ChikaraHanakawa/SweetsVendingMachine/hardware/README.md

# 筐体（ハードウェア）

研究室菓子自販機の 3D プリント筐体です．1 レーン・スパイラル式で，菓子袋を 5 個収納できます．

| ファイル | 内容 |
|---|---|
| [`BOM.md`](BOM.md) | 部品表（印刷部品・電子部品・ケーブル・ねじ） |
| [`stl/`](stl/) | 印刷用 STL（67 ファイル，ファイル名 = ボディ名） |
| [`acrylic_window.dxf`](acrylic_window.dxf) | 前面窓のアクリル板（120 × 145 × 2 mm）の外形と穴位置 |

- 外形: 幅 236 × 奥行き 207 × 高さ 246 mm（操作パネル・脚を含む）
- 内寸: 幅 124 × 奥行き 199 × 高さ 235 mm
- 設計: Autodesk Fusion（`Snack_Vending_Machine`）

## 構成

```
            ┌──────────── 天板 ────────────┐
  操作パネル │  モータ │  スパイラル（5 巻き） │ 窓（アクリル）
  ・PaSoRi   │  取付板 │                      │
  ・LED      ├─────────── 商品棚 ───────────┤ ← Z = 90
  ・スピーカー│ 電装室（Pi / Arduino / ULN2003）│
             │                  ＼ シュート    │ 取り出し口
            └──────────── 底板 ────────────┘
             背面                            前面
```

- スパイラルが 1 回転すると，袋が 1 個ずつ前へ送られ，棚の前端からシュートへ落ちます．
- 操作パネル（PaSoRi・LED・スピーカー）は**正面から見て右側**に付きます．

### 部品名の L / R について

部品名の L / R は設計座標（X の小さい側が L）で付けています．
**正面から見ると `Side_L` が右側（操作パネル側），`Side_R` が左側**になります．

### ブラケットの番号と取り付け位置

| 番号 | 継ぎ目 |
|---|---|
| `BR_01`〜`06` | 底板 × 側板下段（L: `01`〜`03`，R: `04`〜`06`） |
| `BR_07`, `08` | 底板 × 背面下段 |
| `BR_09`, `10` | 底板 × 前面下段（シュートの角の切り欠きに入る細幅） |
| `BR_11`〜`14` | 棚の下 × 側板下段（L: `11`, `12`，R: `13`, `14`） |
| `BR_15`〜`18` | 棚の上 × 側板上段（L: `15`, `16`，R: `17`, `18`） |
| `BR_19`, `20` | 棚の下 × 背面下段 |
| `BR_21`, `22` | 棚の上 × 背面上段 |
| `BR_23`〜`26` | モータ取付板 × 側板上段（L: `23`, `24`，R: `25`, `26`） |
| `BR_27`, `28` | モータ取付板 × 棚 |
| `BR_29`, `30` | シュート後ろ壁 × 底板 |
| `BR_31`〜`38` | 縦の角（L: 背面下 `31`・背面上 `32`・前面下 `33`・前面上 `34`，R: `35`〜`38` 同順） |
| `BR_39`〜`42` | 天板 × 側板上段 |
| `BR_43`〜`46` | 天板 × 前面上段（`43`, `45`）・背面上段（`44`, `46`） |

## 印刷

部品ごとの向きとサポートは [`BOM.md`](BOM.md) を参照してください．
サポートが必要なのはスパイラルだけです（ツリーサポート）．

## 組み立て前の準備

1. **ナットを入れる:** ブラケット・電装ベース・つなぎ板の六角穴に M3 ナットを押し込みます．
   操作パネル箱のフランジの六角穴（8 か所）にも内側から入れ，落ちないようにテープか少量の接着剤で留めます．
2. **アクリル板を加工する:** [`acrylic_window.dxf`](acrylic_window.dxf) のとおり，120 × 145 mm に切り，
   Ø3.4 の穴を 11 個あけます（窓の固定用 4 個 + ボルトの通し穴 7 個）．
   図の原点は，**箱の内側から見た左下の角**です．
3. **ボルト長さの目安:** 板 1 枚とブラケットを留める箇所は M3 × 8，
   棚（厚さ 5 mm）・アクリル板を挟む箇所・つなぎ板は M3 × 10 です．

## 組み立て手順

操作パネル箱の固定ボルトは**本体の内側から締めます**．シュートと棚を付けると手が届かなくなる箇所があるため，
次の順番で組み立ててください．

### 1. 底と電装ベース

1. 底板（前・後）を並べ，`BR_01`〜`08` を底板に留めます（ボルトの頭は底板の下面）．
   `BR_03` は側板側の穴を開けたままにします（手順 3 で操作パネルと共用）．
2. 電装ベースを底板に載せ，8 本で留めます（頭は底板の下面，ナットは電装ベース側）．
   このボルトが底板の前後もつなぎます．
3. Raspberry Pi 5 をスタンドオフに M2.5 × 6 で留めます．USB ポートを右（X の大きい側）に向けます．
4. ULN2003 と USB ハブを結束バンドで留めます．

### 2. 側板下段・背面下段

1. Arduino UNO R4 Minima を側板 L 下段のボスに M3 × 6 で留めます．
   **ヘッダのすぐ横のボス（上側の 1 か所）は，ねじの頭がヘッダに当たるため使いません．**
2. 側板 L 下段・R 下段を `BR_01`〜`06` に外側から留めます（`BR_03` の側板側を除く）．
3. 背面下段を `BR_07`, `08` と角の `BR_31`, `35` で留めます．
4. `BR_33`（前面下段の左の角）を，**側板 L 下段にだけ**先に留めておきます．
   このボルトの頭は，後で操作パネルの裏に隠れます．

### 3. 操作パネル

先に箱の中身を組み立ててから，側板 L 下段に取り付けます．

1. LED（緑・赤）を前面の穴に差し，ホットボンドで固定します．
2. スピーカーをスピーカー台に載せ，結束バンド（200 mm）を台の通し穴から両側の壁の外を回し，
   スピーカーの背面で締めます．スピーカーが前面の壁に押し付けられます．
3. スピーカー台を箱の底の下から M3 × 6 × 2 本で留めます．
4. PaSoRi を**ケーブルを挿さずに**開口側から入れます．**コネクタを上，読み取り面を前**に向け，
   受け台と爪の間を奥（止まる位置）まで滑らせます．
5. L 字 mini-USB ケーブルを上から差し込みます．プラグの頭は爪の切り欠きに収まります．
6. PaSoRi 押さえを開口側から M3 × 8 × 2 本で留めます．
7. ケーブルを次の順に通します．
   1. プラグのすぐ後ろで，天井下のリブの U 字の通し穴に結束バンドを通し，ケーブルを留めます．
   2. ケーブルを箱の後ろの壁へ回し，壁に沿って下ろします．
   3. 後ろの壁の 2 本のスリット（下から約 50 mm）にも結束バンドを通して留め，その間にたるみを残します．
   4. Z = 40 より下を通して，配線穴から本体側へ出します．
8. LED とスピーカーの配線も配線穴から本体側へ出します．
9. 箱を側板 L 下段に当て，**本体の内側から**次の 4 本を締めます．
   - 配線穴の真下と真上の 2 本（後ろから 126.5 mm，下から 14 mm・80 mm）
   - 底近くの 1 本（後ろから 144 mm，下から 6.5 mm）
   - `BR_03` を通る 1 本（M3 × 10．頭は `BR_03` の六角穴に入る）

### 4. シュートと棚

1. `BR_29`, `30` をシュートの後ろ壁に留め（頭は斜面の下側），シュートを置いて底板に下から留めます．
2. 棚に，棚側のボルトを先に入れたブラケットを付けておきます（作業台の上で行う）．
   - 棚の下: `BR_11`〜`14`，`BR_19`, `20`（頭は棚の上面）
   - 棚の上: `BR_15`, `17`, `18`，`BR_21`, `22`，`BR_27`, `28`（頭は棚の下面）
   - **`BR_16`（左前・上側）はまだ付けません．**
3. 棚を左右の側板下段の間に入れ（上面を側板下段の上端にそろえる），`BR_11`〜`14` を側板に，`BR_19`, `20` を背面下段に外側から留めます．

### 5. 側板上段

1. `BR_16` を，**側板 L 上段に先に**外側から留めておきます．
   このボルトの頭は操作パネルの裏に隠れるため，取り付け後は回せません．
2. 側板 L 上段・R 上段を上から差し込みます．
   L 上段は，操作パネルのフランジと本体の間に滑り込ませます．
3. `BR_15`〜`18` の残りの穴を留めます．`BR_16` の棚側は，前の取り出し口から棚の下に手を入れて留めます．
4. 操作パネルの上側の 4 本を本体の内側から締めます．
   - 配線穴と同じ列（後ろから 126.5 mm）の上の 2 本（下から 130 mm・175 mm）
   - 上の角の 1 本（下から 183.5 mm，後ろから 140 mm）
   - `BR_34` を通る 1 本（M3 × 10．`BR_34` を側板 L 上段に留めるボルトを兼ねる）

### 6. モータとスパイラル

1. 28BYJ-48 をモータ取付板の座ぐりに当て，M3 × 8 とナットで留めます．
2. カプラを軸に押し込みます．
3. モータ取付板を `BR_27`, `28`（棚）と `BR_23`〜`26`（側板上段）で留めます．
   取付板側のボルトは，背面（モータ室）側から入れます．
4. モータの配線を棚の長穴から電装室へ通します．
5. スパイラルを前から差し込み，ハブの六角穴をカプラにはめます．
   商品を手前に送るには，**背面から見て反時計回り**に回します．

### 7. 前面パネル

1. つなぎ板を前面下段の内側に当て，下の列 3 本を外側から M3 × 10 で留めます．
2. 前面下段を `BR_33`, `37`（角）と `BR_09`, `10`（シュートの角の切り欠き．底板側は下から）で留めます．
3. アクリル板を前面上段の内側に当て，四隅を M3 × 5 で留めます．
4. 前面上段を載せ，つなぎ板の上の列 3 本と，角の `BR_34`, `38` を外側から M3 × 10 で留めます（アクリル板を貫通）．

### 8. 背面上段（点検蓋）と天板

1. 背面上段を，角の `BR_32`, `36` と棚の `BR_21`, `22` で留めます．
2. 天板に `BR_39`〜`46` を天板側から留めておき，本体に載せて側板・前面・背面に外側から留めます．
   前面の `BR_43`, `45` はアクリル板を貫通するので M3 × 10 です．
3. 背面上段は，`BR_32`, `36`, `21`, `22`, `44`, `46` の 6 本を外すと取り外せます（モータ点検用）．

## 配線

| ケーブル | 経路 |
|---|---|
| Raspberry Pi 電源 | 背面下段のケーブル穴（背面から見て左下）から |
| Arduino ↔ Pi | Arduino の USB-C に L 字プラグ（背面下段の窓側）→ 電装室内で Pi へ |
| PaSoRi・スピーカー・LED | 操作パネルの配線穴 → 電装室内で Pi / Arduino へ |
| モータ | 棚の長穴 → ULN2003 |

背面下段の窓からは，筐体を開けずに Arduino へ書き込みできます．

## 未確認の点（実物合わせ）

- Arduino の取付穴位置（3D モデルに穴の形状がないため未照合）
- スピーカー（MS-U1）・USB ハブ・ULN2003 の寸法は仮の値です
- 28BYJ-48 の軸がカプラに約 7 mm 入る想定です（取付面から軸先端まで約 10 mm）
