ChikaraHanakawa/SweetsVendingMachine/qml/assets/soldout-zunda.gif

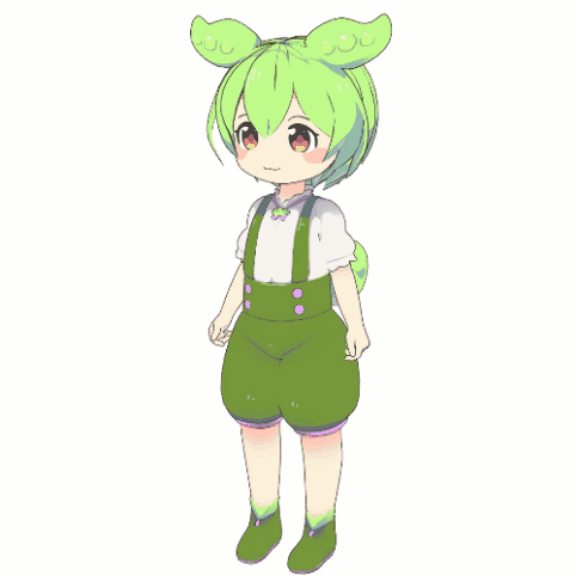
qml/assets/soldout-zunda.gif
