ChikaraHanakawa/SweetsVendingMachine/qml/assets/zunda-preparing.gif

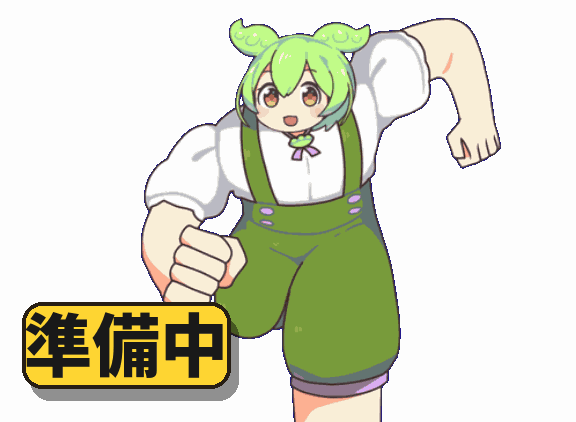
qml/assets/zunda-preparing.gif
