ChikaraHanakawa/SweetsVendingMachine/qml/assets/zunda-white.gif

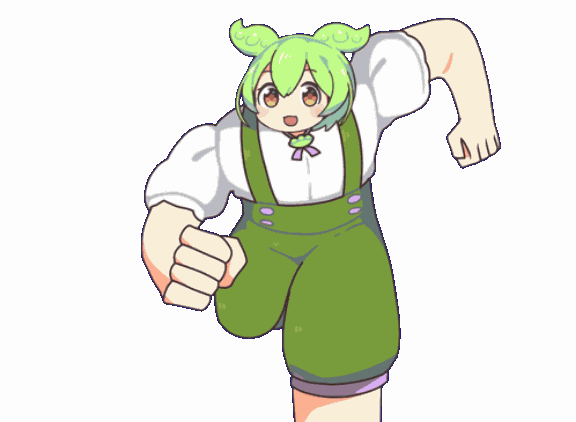
qml/assets/zunda-white.gif
