ChikaraHanakawa/SweetsVendingMachine/hardware/BOM.md

# 部品表（BOM）

筐体（1 レーン・スパイラル式）の組み立てに必要な部品の一覧です．
組み立て手順は [README.md](README.md) を参照してください．

## 1. 3D プリント部品

STL は [`stl/`](stl/) にあり，ファイル名はボディ名と同じです．
STL は組み立て状態の座標のまま出力しているので，スライサーで下表の向きに回転してから印刷してください．
すべて 210 × 190 × 240 mm（Adventurer 4 Lite の余裕込み）に収まります．

| ファイル | 部品 | 数 | 外形 X×Y×Z (mm) | 印刷の向き | サポート |
|---|---|---|---|---|---|
| `Spiral.stl` | スパイラル | 1 | 70 × 117 × 70 | ハブ円板を下 | **ツリーサポート要** |
| `Coupler_28BYJ.stl` | モータ軸カプラ | 1 | 11.5 × 11 × 10 | 六角面を下 | 不要 |
| `MotorPlate.stl` | モータ取付板 | 1 | 124 × 10 × 145 | 前面（リブのない面）を下 | 不要 |
| `ShelfTray.stl` | 商品棚 | 1 | 124 × 150 × 13 | 上面を下（リブを上） | 不要 |
| `Floor_Rear.stl` | 底板（後） | 1 | 132 × 107.5 × 7 | 上面を下（脚を上） | 不要 |
| `Floor_Front.stl` | 底板（前） | 1 | 132 × 99.5 × 7 | 上面を下（脚を上） | 不要 |
| `Chute.stl` | 取り出しシュート | 1 | 124 × 62 × 30 | 後ろ壁の外面を下 | 不要 |
| `Side_L_Lower.stl` | 側板 L 下段 | 1 | 14 × 207 × 90 | 外面を下（ボスを上） | 不要 |
| `Side_L_Upper.stl` | 側板 L 上段 | 1 | 4 × 207 × 145 | 内面を下 | 不要 |
| `Side_R_Lower.stl` | 側板 R 下段 | 1 | 4 × 207 × 90 | 外面を下 | 不要 |
| `Side_R_Upper.stl` | 側板 R 上段 | 1 | 4 × 207 × 145 | 内面を下 | 不要 |
| `Front_Lower.stl` | 前面パネル 下段 | 1 | 124 × 4 × 90 | 外面を下 | 不要 |
| `Front_Upper.stl` | 前面パネル 上段 | 1 | 124 × 4 × 145 | 外面を下 | 不要 |
| `Rear_Lower.stl` | 背面パネル 下段 | 1 | 124 × 4 × 90 | 外面を下 | 不要 |
| `Rear_Upper.stl` | 背面パネル 上段（点検蓋） | 1 | 124 × 4 × 145 | 外面を下 | 不要 |
| `Top.stl` | 天板 | 1 | 132 × 207 × 4 | 下面を下 | 不要 |
| `ElecBase.stl` | 電装ベース | 1 | 120 × 130 × 11 | 底面を下 | 不要 |
| `FrontSplice.stl` | 前面パネル上下のつなぎ板 | 1 | 92 × 5 × 24 | 段のない面（ナット穴の面）を下 | 不要 |
| `ControlPanel.stl` | 操作パネル箱 | 1 | 104 × 83 × 190 | 開口と反対の側面を下 | 不要 |
| `SpeakerCradle.stl` | スピーカー台 | 1 | 90 × 35 × 15 | 底面を下 | 不要 |
| `PasoriClamp.stl` | PaSoRi 押さえ | 1 | 63 × 13 × 118.5 | 背面の板を下 | 不要 |
| `BR_01`〜`BR_46.stl` | L 字ブラケット | 46 | 下表 | L 字の断面が見える向き | 不要 |

- 外面が見える部品（前面・背面・側板・天板・操作パネル）は，見える面をベッド側にすると仕上がりがきれいです．
- 側板と天板は 207 mm の辺をベッドの X 方向（210 mm）に合わせてください．

### L 字ブラケットの内訳

形の同じものは同じ STL を複数回印刷して構いません．

| 種類 | 外形 (mm) | 数 | ファイル |
|---|---|---|---|
| 標準 | 15 × 15 × 20 | 36 | `BR_01`〜`08`, `11`〜`14`, `16`, `18`, `23`〜`32`, `34`〜`36`, `38`〜`46` |
| 細幅（シュート角） | 21 × 15 × 7 | 2 | `BR_09`, `BR_10` |
| 奥行き 19 | 15 × 15 × 19 | 2 | `BR_15`, `BR_17` |
| 奥行き 18 | 15 × 15 × 18 | 4 | `BR_19`〜`BR_22` |
| 前面下段の角 | 21 × 15 × 12 | 2 | `BR_33`, `BR_37` |

### 推奨の印刷設定

- 材料: PLA
- 積層ピッチ 0.2 mm，壁 3 周以上
- インフィル: パネル類 20 %，ブラケット・カプラ・スパイラル 40 % 以上

## 2. 電子部品

| 部品 | 数 | 備考 |
|---|---|---|
| Raspberry Pi 5 | 1 | 電装ベースのスタンドオフに M2.5 で固定 |
| Raspberry Pi 5 用 電源（USB-C，5 V 5 A） | 1 | 背面下段のケーブル穴から通す |
| Arduino UNO R4 Minima | 1 | 側板 L 下段のボスに M3 で固定 |
| ステッピングモータ 28BYJ-48（5 V） | 1 | |
| ULN2003 ドライバ基板 | 1 | 電装ベースに結束バンドで固定 |
| Sony PaSoRi RC-S380 | 1 | 実測 57 × 97.5 × 10 mm |
| スピーカー MS-U1 | 1 | 実測 幅 85 × 高さ 42 × 奥行き 35 mm |
| USB ハブ | 1 | 32 × 60 mm 以内，高さ 22 mm 以内を想定 |
| LED 5 mm（緑・赤） | 各 1 | 電流制限抵抗は回路に合わせて選定 |

## 3. ケーブル

| 部品 | 数 | 備考 |
|---|---|---|
| mini-USB（L 字）– USB-A ケーブル | 1 | PaSoRi 用．**PaSoRi の底面側（台形の幅の広い辺の側）へケーブルが出る向き**のもの．ストレートは入りません |
| USB-C（L 字）– USB-A ケーブル | 1 | Arduino 用．背面下段の窓側へ差す |
| USB-A L 字プラグのケーブル（または L 字アダプタ） | 必要数 | Raspberry Pi の USB ポート用．ポート前の空間は約 20 mm |

## 4. 締結部品・その他

| 部品 | 数 | 用途 |
|---|---|---|
| M3 × 8 ボルト | 90 | ブラケット・電装ベース・操作パネル（86），PaSoRi 押さえ（2），モータ（2） |
| M3 × 10 ボルト | 26 | 棚・アクリル板を挟む箇所・つなぎ板・操作パネル共用部 |
| M3 × 6 ボルト | 5 | スピーカー台（2），Arduino（3） |
| M3 × 5 ボルト | 4 | アクリル板 |
| M3 ナット | 114 | ブラケット等（112），モータ（2） |
| M2.5 × 6 ボルト | 4 | Raspberry Pi |
| M3 ワッシャー | 2 | モータ取付耳（任意） |
| 結束バンド（幅 3.6 mm 以下，長さ 150 mm） | 約 10 | ULN2003・USB ハブ・配線押さえ・PaSoRi ケーブル |
| 結束バンド（幅 3.6 mm 以下，長さ 200 mm） | 1 | スピーカー |
| アクリル板 120 × 145 × 2 mm | 1 | 前面の窓．穴あけ図は [`acrylic_window.dxf`](acrylic_window.dxf) |

- M3 のボルト頭は**高さ 3 mm 以下**のものを使ってください（底板の脚と同じ高さのため）．
- アクリル板の M3 × 5 と，スピーカー台・PaSoRi 押さえ・Arduino のねじは，樹脂の下穴（Ø2.5）に直接ねじ込みます．
