ChikaraHanakawa/SweetsVendingMachine/hardware/acrylic_window.dxf

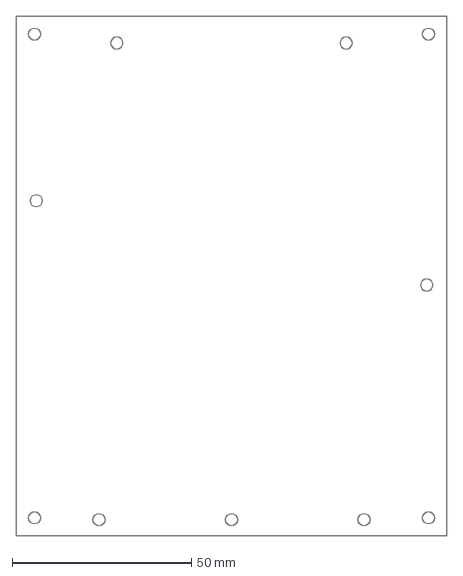
[picture p4: CAD file, 2026-11-08]
hardware/acrylic_window.dxf
120.0 x 145.0 mm
