ChikaraHanakawa/SweetsVendingMachine/hardware/stl/PasoriClamp.stl

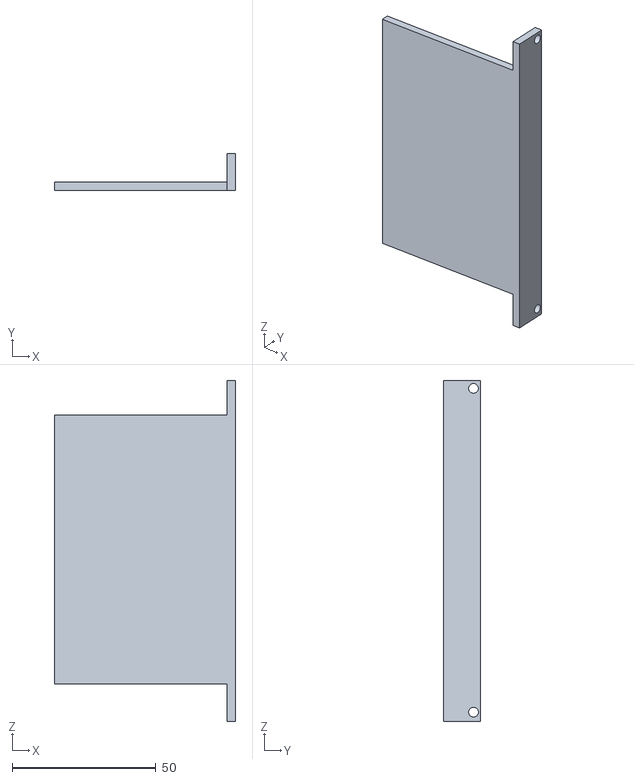
[picture p5: CAD file, 2026-11-11]
hardware/stl/PasoriClamp.stl
63.0 x 13.0 x 118.5
