ChikaraHanakawa/SweetsVendingMachine/hardware/stl/ControlPanel.stl

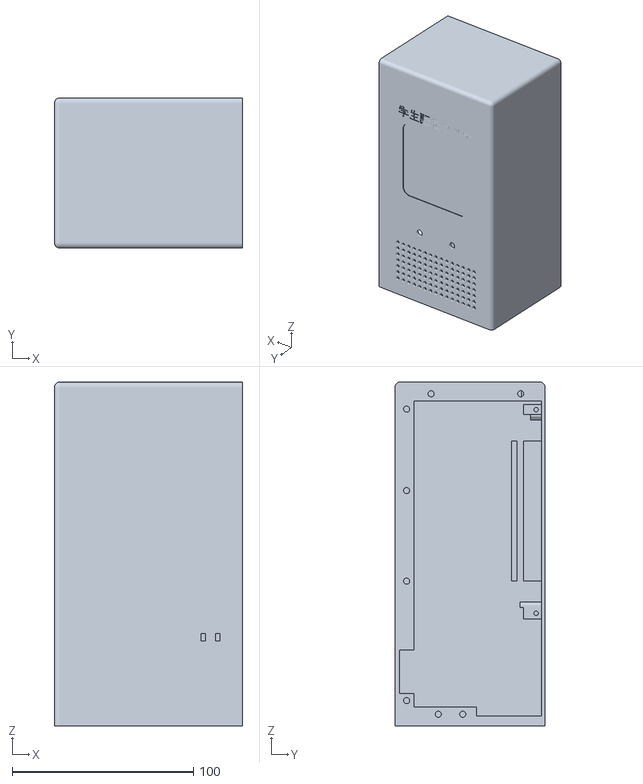
[picture p6: CAD file, 2026-11-11]
hardware/stl/ControlPanel.stl
104.0 x 83.0 x 190.0
