ChikaraHanakawa/SweetsVendingMachine/hardware/stl/SpeakerCradle.stl

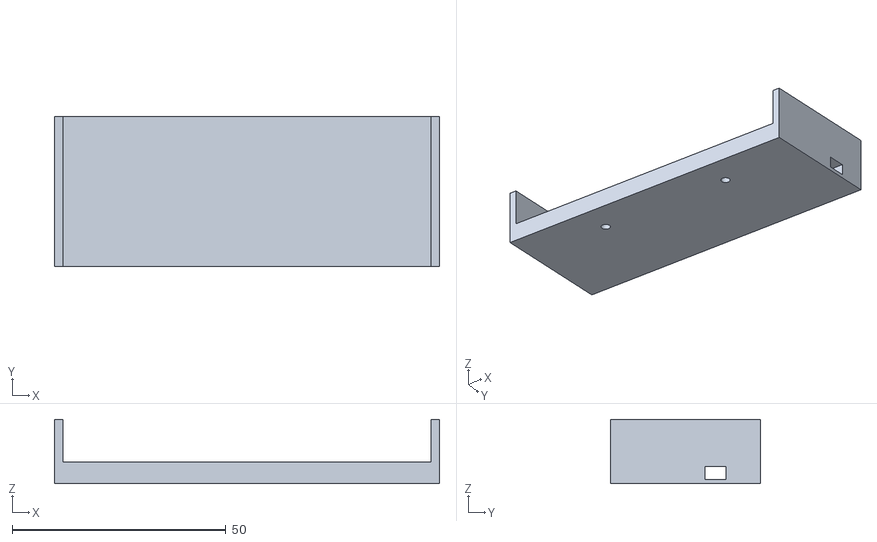
[picture p7: CAD file, 2026-11-11]
hardware/stl/SpeakerCradle.stl
90.0 x 35.0 x 15.0
