ChikaraHanakawa/SweetsVendingMachine/hardware/stl/BR_03.stl

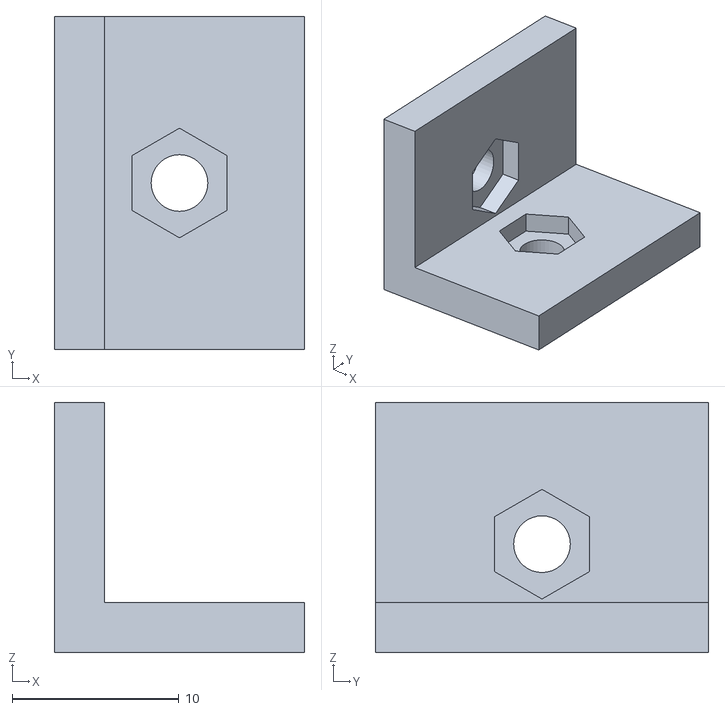
[picture p8: CAD file, 2026-11-08]
hardware/stl/BR_03.stl
15.0 x 20.0 x 15.0
