ChikaraHanakawa/SweetsVendingMachine/hardware/stl/BR_37.stl

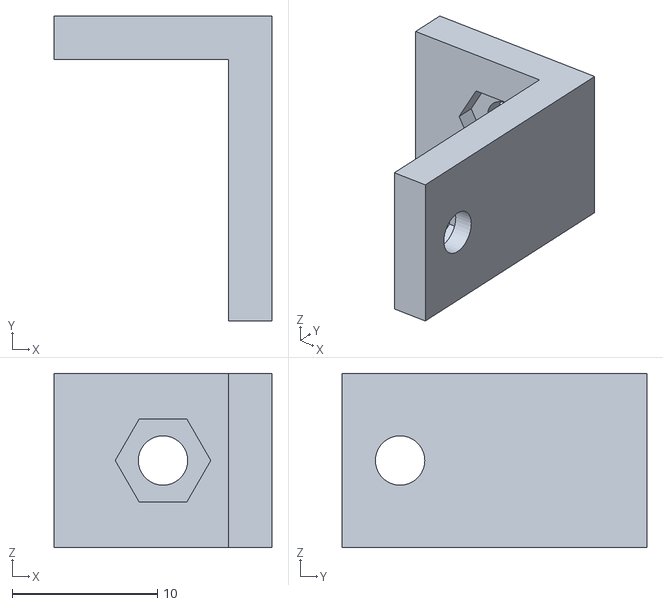
[picture p9: CAD file, 2026-11-08]
hardware/stl/BR_37.stl
15.0 x 21.0 x 12.0
