ChikaraHanakawa/SweetsVendingMachine/hardware/stl/Chute.stl

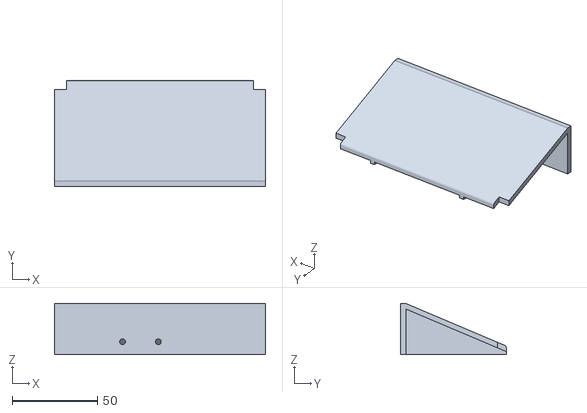
[picture p10: CAD file, 2026-11-08]
hardware/stl/Chute.stl
124.0 x 62.0 x 30.0
