ChikaraHanakawa/SweetsVendingMachine/hardware/stl/FrontSplice.stl

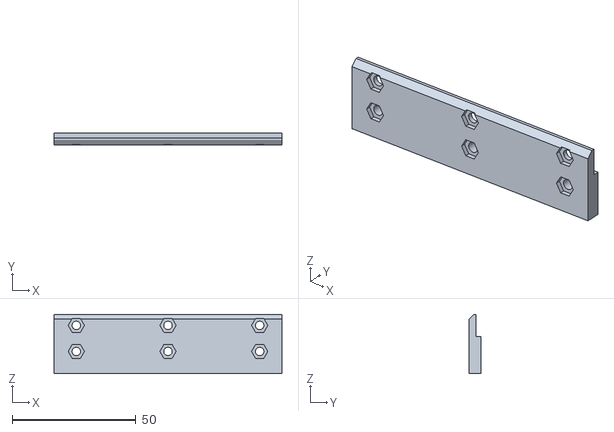
[picture p11: CAD file, 2026-11-08]
hardware/stl/FrontSplice.stl
92.0 x 5.00 x 24.0
