ChikaraHanakawa/SweetsVendingMachine/hardware/stl/Floor_Front.stl

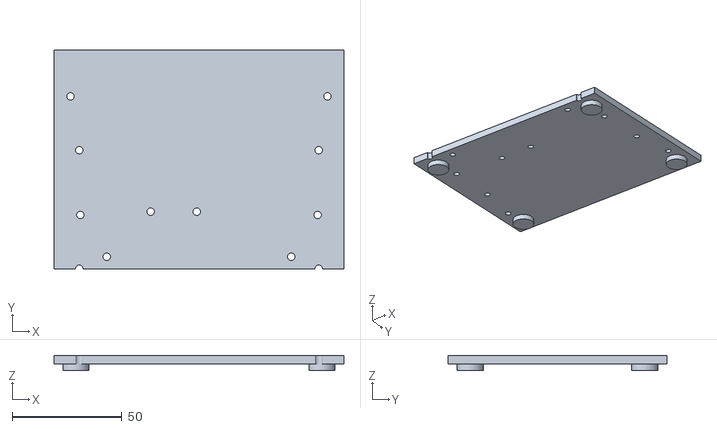
[picture p12: CAD file, 2026-11-08]
hardware/stl/Floor_Front.stl
132.0 x 99.5 x 7.00
