ChikaraHanakawa/SweetsVendingMachine/hardware/stl/BR_17.stl

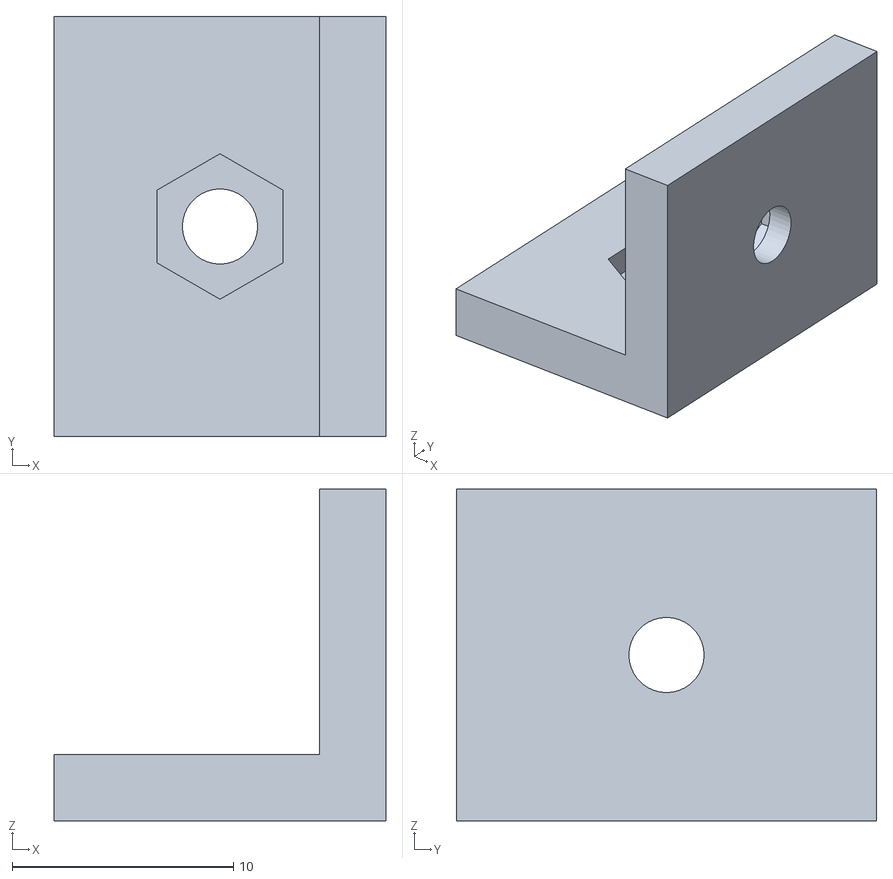
[picture p13: CAD file, 2026-11-08]
hardware/stl/BR_17.stl
15.0 x 19.0 x 15.0
