ChikaraHanakawa/SweetsVendingMachine/hardware/stl/BR_22.stl

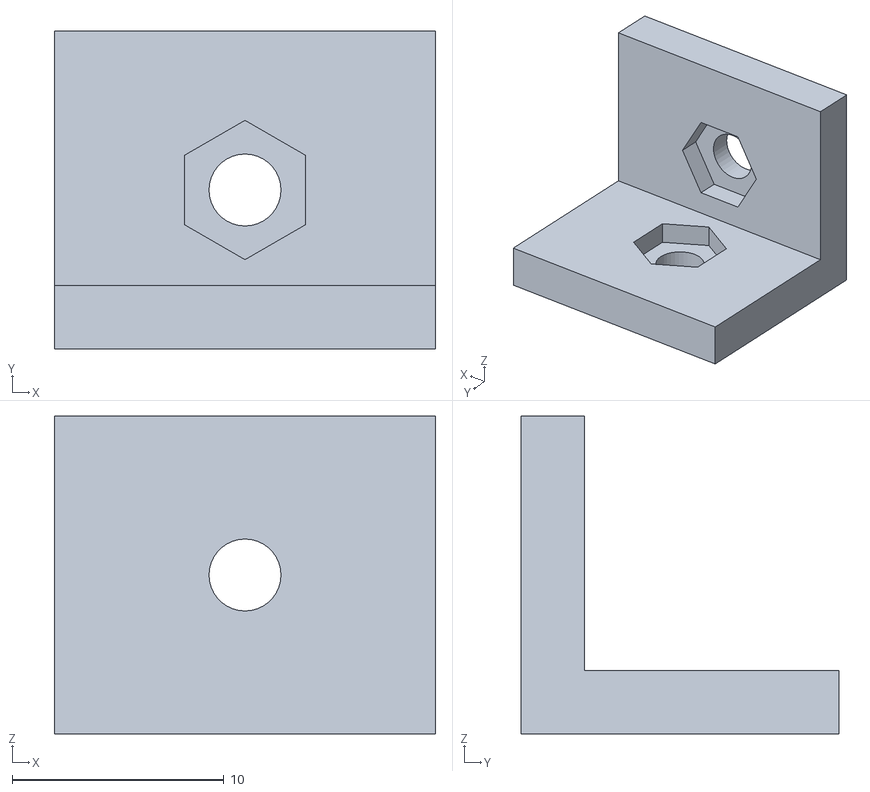
[picture p14: CAD file, 2026-11-08]
hardware/stl/BR_22.stl
18.0 x 15.0 x 15.0
