ChikaraHanakawa/SweetsVendingMachine/hardware/stl/ElecBase.stl

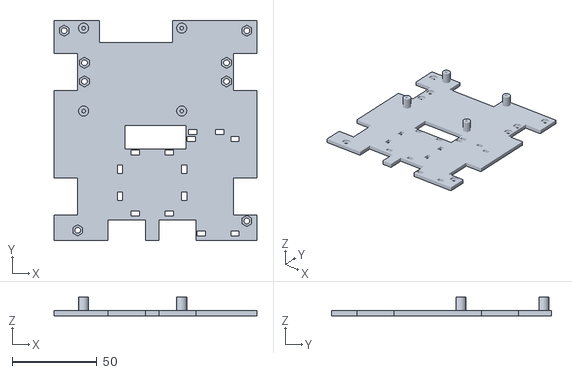
[picture p15: CAD file, 2026-11-08]
hardware/stl/ElecBase.stl
120.0 x 130.0 x 11.0
