ChikaraHanakawa/SweetsVendingMachine/hardware/stl/Side_L_Upper.stl

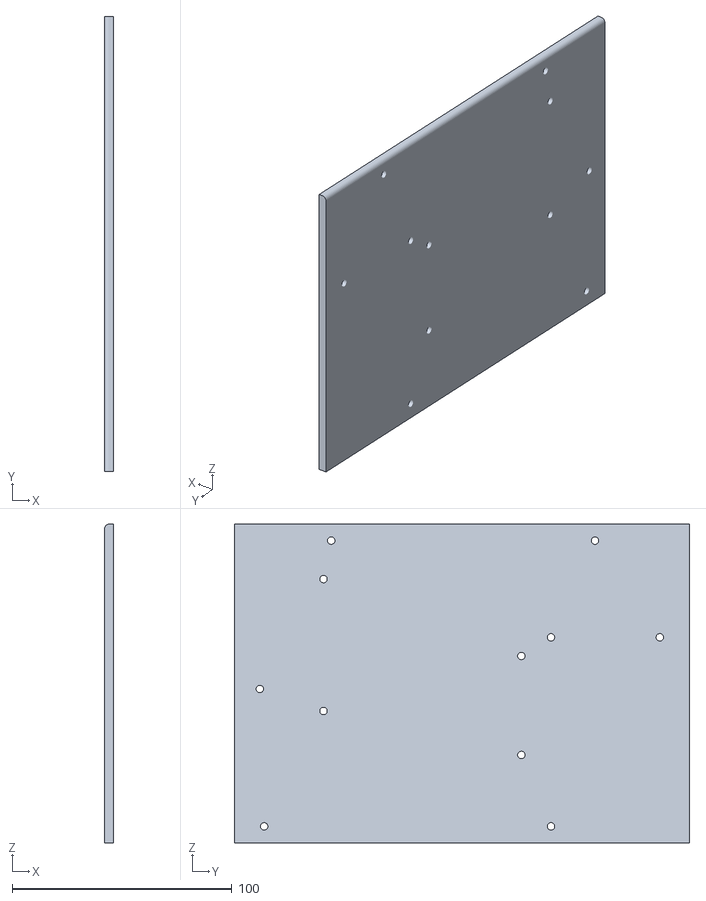
[picture p16: CAD file, 2026-11-08]
hardware/stl/Side_L_Upper.stl
4.00 x 207.0 x 145.0
