ChikaraHanakawa/SweetsVendingMachine/hardware/stl/Rear_Upper.stl

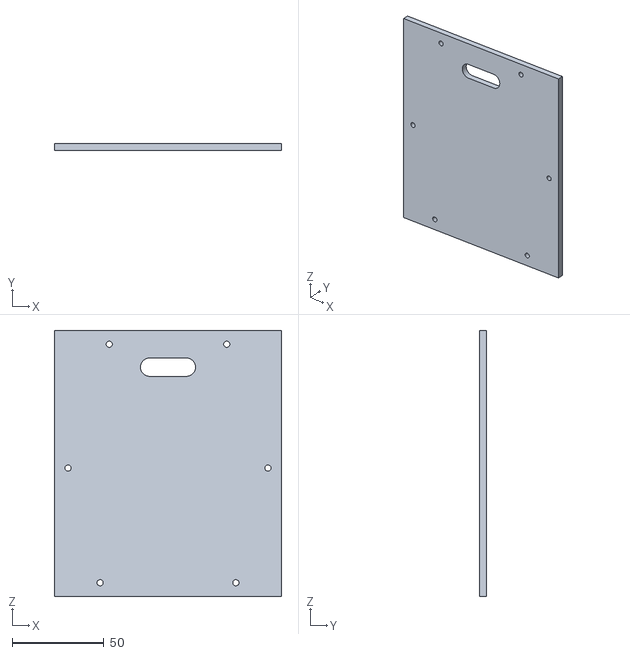
[picture p17: CAD file, 2026-11-08]
hardware/stl/Rear_Upper.stl
124.0 x 4.00 x 145.0
