ChikaraHanakawa/SweetsVendingMachine/hardware/stl/Top.stl

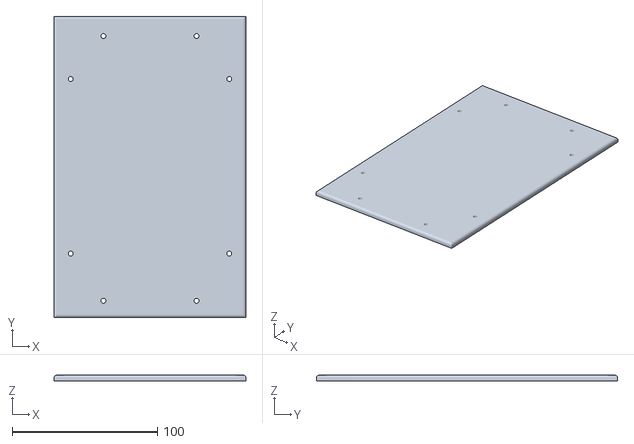
[picture p18: CAD file, 2026-11-08]
hardware/stl/Top.stl
132.0 x 207.0 x 4.00
