ChikaraHanakawa/SweetsVendingMachine/hardware/stl/Spiral.stl

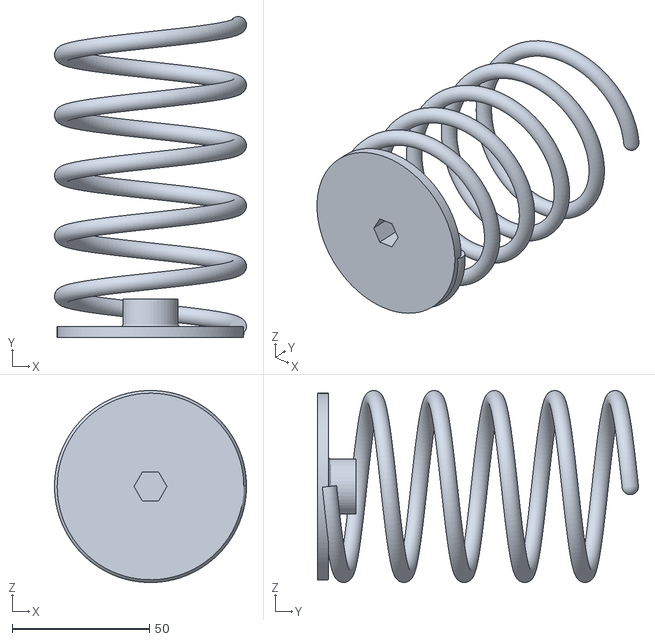
[picture p19: CAD file, 2026-11-08]
hardware/stl/Spiral.stl
70.0 x 117.0 x 70.0
