ChikaraHanakawa/SweetsVendingMachine/hardware/stl/Coupler_28BYJ.stl

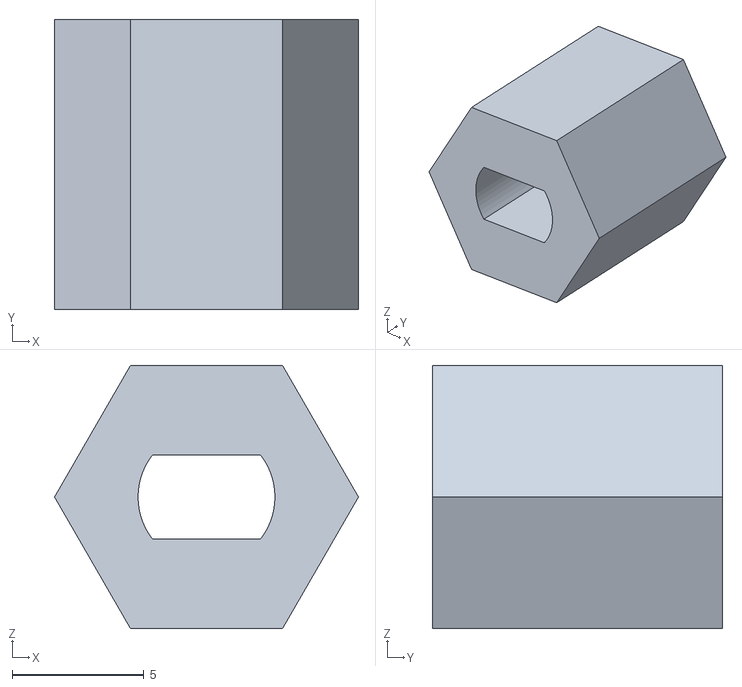
[picture p20: CAD file, 2026-11-08]
hardware/stl/Coupler_28BYJ.stl
11.5 x 11.0 x 10.0
