ChikaraHanakawa/SweetsVendingMachine/hardware/stl/ShelfTray.stl

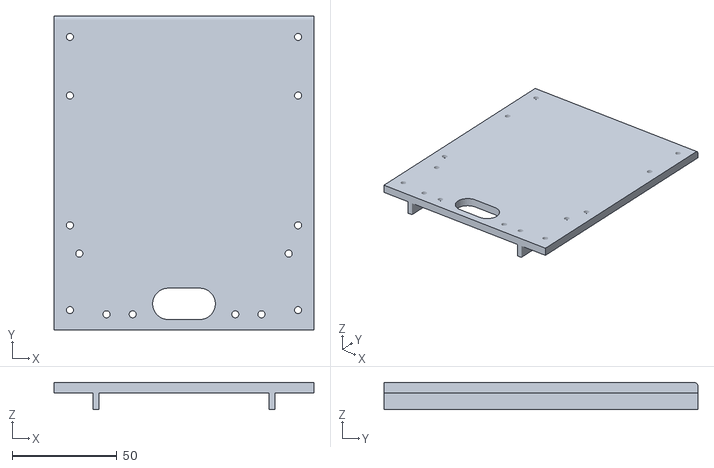
[picture p21: CAD file, 2026-11-08]
hardware/stl/ShelfTray.stl
124.0 x 150.0 x 13.0
