ChikaraHanakawa/SweetsVendingMachine/hardware/stl/Side_L_Lower.stl

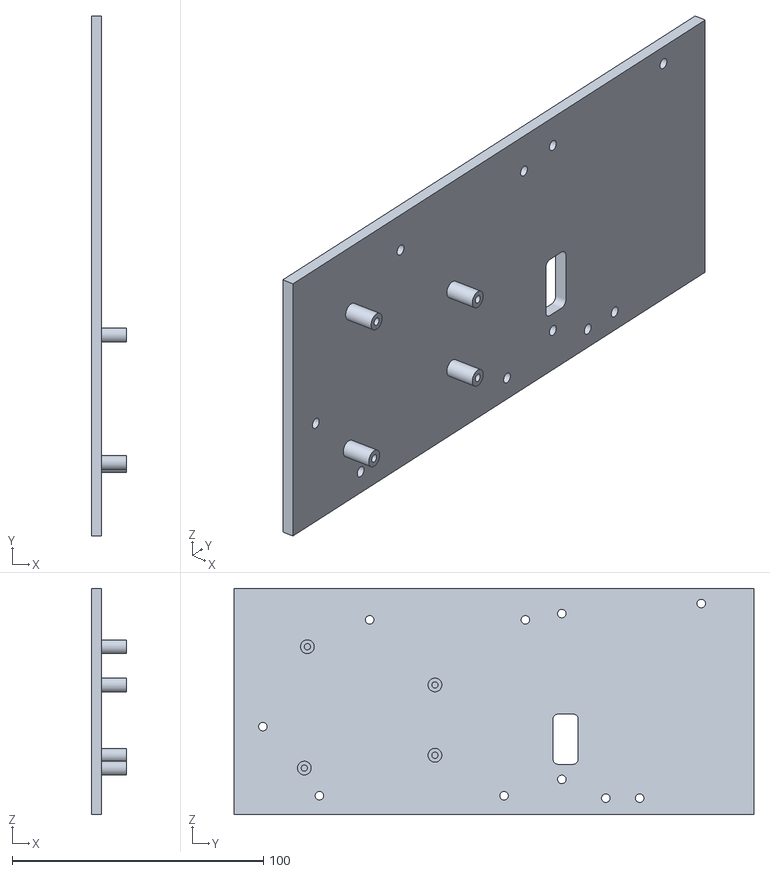
[picture p22: CAD file, 2026-11-08]
hardware/stl/Side_L_Lower.stl
14.0 x 207.0 x 90.0
