ChikaraHanakawa/SweetsVendingMachine/hardware/stl/Side_R_Lower.stl

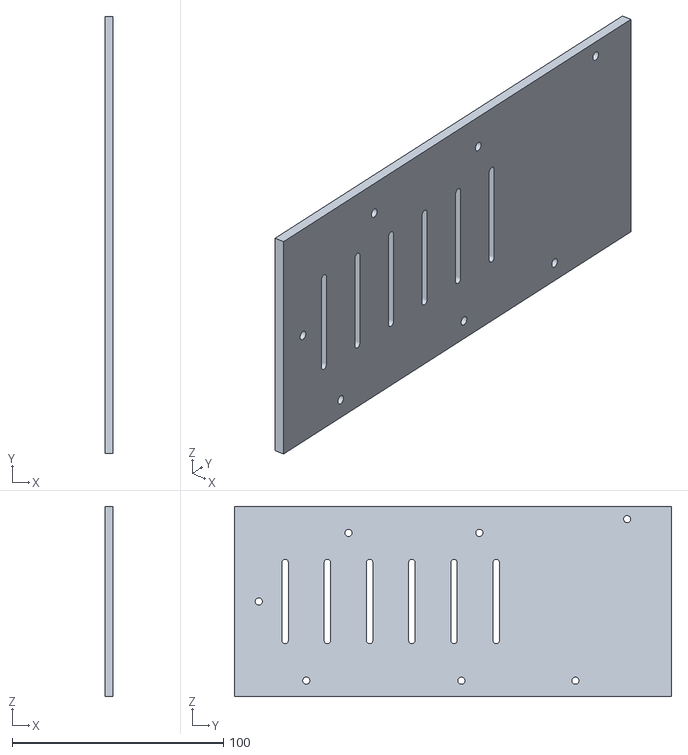
[picture p23: CAD file, 2026-11-08]
hardware/stl/Side_R_Lower.stl
4.00 x 207.0 x 90.0
