ChikaraHanakawa/SweetsVendingMachine/hardware/stl/Front_Lower.stl

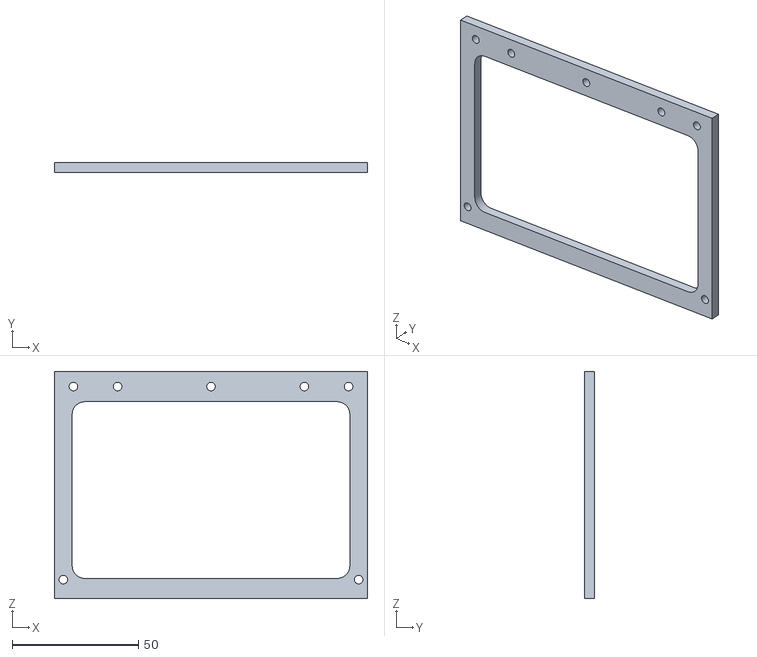
[picture p24: CAD file, 2026-11-08]
hardware/stl/Front_Lower.stl
124.0 x 4.00 x 90.0
