ChikaraHanakawa/SweetsVendingMachine/hardware/stl/Front_Upper.stl

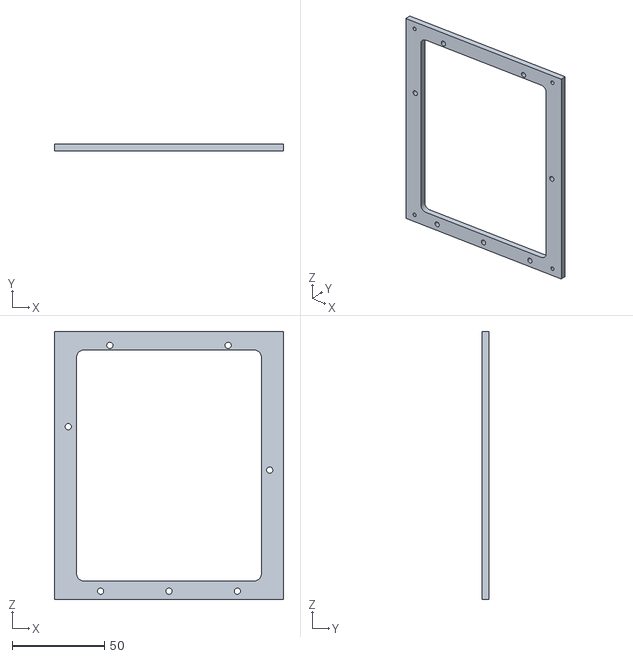
[picture p25: CAD file, 2026-11-08]
hardware/stl/Front_Upper.stl
124.0 x 4.00 x 145.0
