ChikaraHanakawa/SweetsVendingMachine/hardware/stl/Floor_Rear.stl

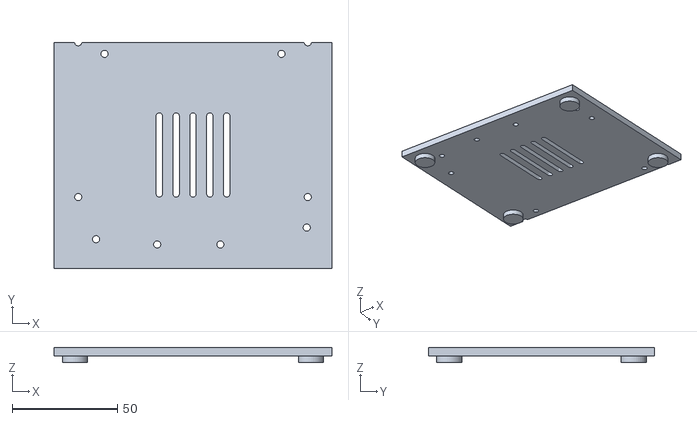
[picture p26: CAD file, 2026-11-08]
hardware/stl/Floor_Rear.stl
132.0 x 107.5 x 7.00
