ChikaraHanakawa/SweetsVendingMachine/hardware/stl/MotorPlate.stl

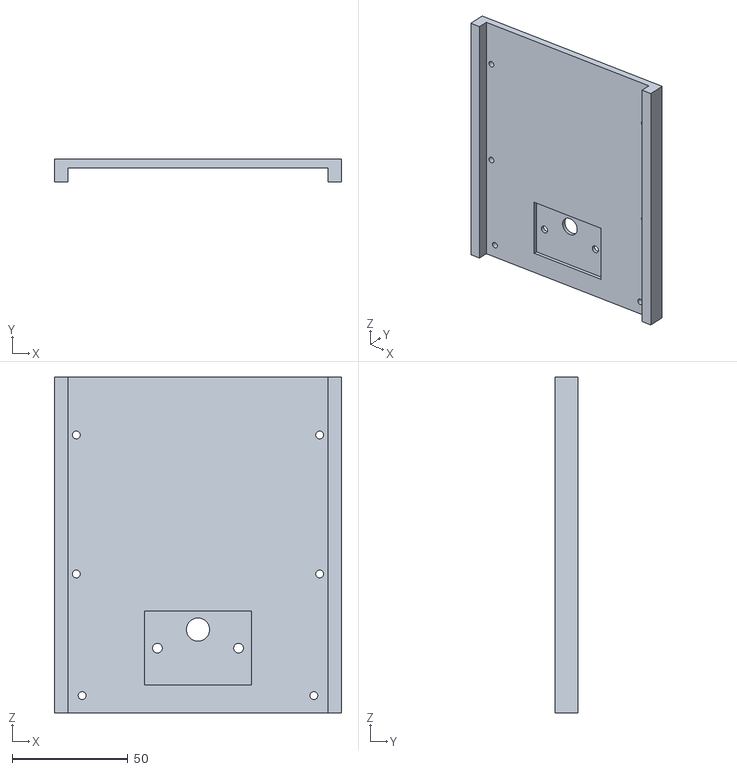
[picture p27: CAD file, 2026-11-08]
hardware/stl/MotorPlate.stl
124.0 x 10.0 x 145.0
