ChikaraHanakawa/SweetsVendingMachine/hardware/stl/Rear_Lower.stl

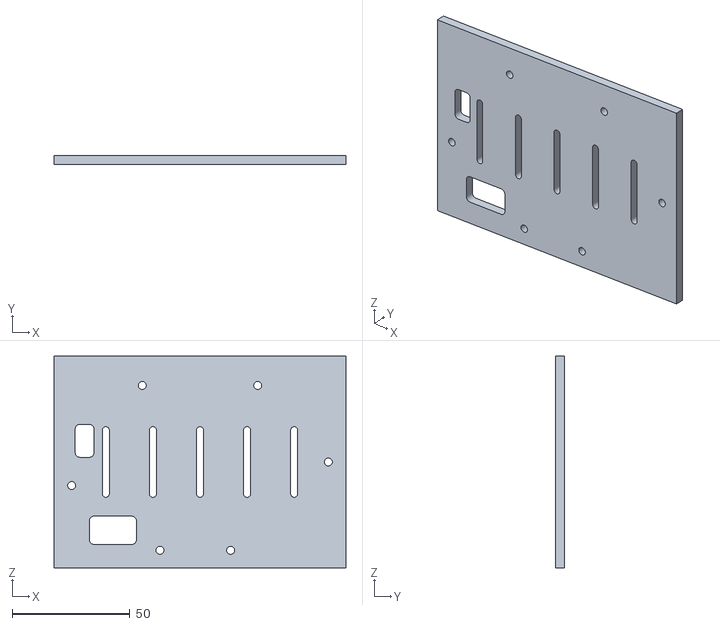
[picture p28: CAD file, 2026-11-08]
hardware/stl/Rear_Lower.stl
124.0 x 4.00 x 90.0
