ChikaraHanakawa/SweetsVendingMachine/hardware/stl/BR_10.stl

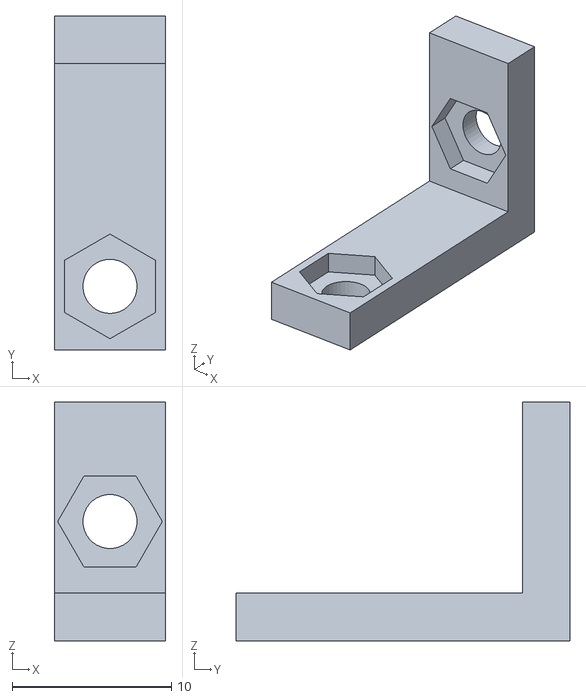
[picture p29: CAD file, 2026-11-08]
hardware/stl/BR_10.stl
7.00 x 21.0 x 15.0
