ChikaraHanakawa/SweetsVendingMachine/(list of files, cad)

Other CAD files:
hardware/stl/BR_35.stl
hardware/stl/BR_12.stl
hardware/stl/BR_29.stl
hardware/stl/BR_36.stl
hardware/stl/BR_25.stl
hardware/stl/BR_16.stl
hardware/stl/BR_34.stl
hardware/stl/BR_39.stl
hardware/stl/BR_18.stl
hardware/stl/BR_30.stl
hardware/stl/BR_26.stl
hardware/stl/BR_27.stl
hardware/stl/BR_01.stl
hardware/stl/BR_33.stl
hardware/stl/BR_23.stl
hardware/stl/BR_15.stl
hardware/stl/BR_31.stl
hardware/stl/BR_38.stl
hardware/stl/BR_02.stl
hardware/stl/BR_46.stl
hardware/stl/BR_28.stl
hardware/stl/BR_41.stl
hardware/stl/BR_40.stl
hardware/stl/BR_14.stl
hardware/stl/BR_07.stl
hardware/stl/BR_21.stl
hardware/stl/BR_04.stl
hardware/stl/BR_11.stl
hardware/stl/BR_43.stl
hardware/stl/BR_05.stl
hardware/stl/Side_R_Upper.stl
hardware/stl/BR_20.stl
hardware/stl/BR_13.stl
hardware/stl/BR_44.stl
hardware/stl/BR_32.stl
hardware/stl/BR_06.stl
hardware/stl/BR_45.stl
hardware/stl/BR_19.stl
hardware/stl/BR_42.stl
hardware/stl/BR_24.stl
hardware/stl/BR_08.stl
hardware/stl/BR_09.stl
