ChikaraHanakawa/SweetsVendingMachine/src/nfc_bridge.cpp

#include "common.h"
#include "nfc_bridge.h"
#include "aplay.h"
#include "read_csv.h"

#include <pybind11/embed.h>

extern std::atomic<bool> running;

void feedback_play_wav(int state){
    std::string path = "database/wav/";
    switch (state){
        case 0 :
            path += "reg_student.wav";
            break;
        case 1 :
            path += "not_reg_student.wav";
            break;
        case 2 :
            path += "error_student.wav";
            break;
    }
    zundamon_wav(path);  
}                           

void nfc_py_read(){     
    std::cout << "[Read] CSVファイルを読み込みます" << std::endl;
    InputCsvObject member = reading_csv();
    std::map<std::string, std::string> table = member.get_lab_member();

    pybind11::scoped_interpreter guard{};
    std::cout << "[pybind11] 認証システムを開始します" << std::endl;
    try {
        pybind11::module_ sys = pybind11::module::import("sys");
        sys.attr("path").cast<pybind11::list>().append("./src/");
        sys.attr("path").cast<pybind11::list>().append(".");

        pybind11::module_ nfc_mod = pybind11::module_::import("nfc_reader");

        std::cout << "カードをかざして下さい" << std::endl;

        while (running){
            std::string student_id = nfc_mod.attr("NFCReader")().attr("read_student_id")().cast<std::string>();

            if (!running) break;
            if (student_id.empty() || student_id.rfind("Error", 0) == 0) continue;

            if (!student_id.empty() && student_id.rfind("Error", 0) != 0){
                std::cout << "[Success] 学籍番号: " << student_id << std::endl;
                if (table.find(student_id) != table.end()) {
                    std::cout << "[Registered] 登録済みメンバーです" << std::endl;
                    feedback_play_wav(0);
                } else {
                    std::cout << "[Not Registered] 未登録のメンバーです" << std::endl;
                    feedback_play_wav(1);
                }
            } else {
                std::cerr << "[Error] 読み取り失敗; " << student_id << std::endl;
                feedback_play_wav(2);
            }
            std::this_thread::sleep_for(std::chrono::seconds(2));
        }
    }
    catch (pybind11::error_already_set &e){
        if (e.matches(PyExc_KeyboardInterrupt)){
            std::cout << "[Info] KeyboardInterruptを受信しました" << std::endl;
        } else if (running){
            std::cerr << "[Except] Python側での例外発生:\n" << e.what() << std::endl;
        }
    }
    std::cout << "[Info] NFCリーダーを停止しました" << std::endl;
}
